Hans-JR/NMEA-Motor-Diagnose/README.md

# NMEA-Motor-Diagnose
Monitors several Boot Engine Parameter and converts them into the NMEA0183 protocoll

The Project is listet under the URL https://open-boat-projects.org/de/diy-motordiagnose/
