Hans-JR/NMEA-Motor-Diagnose/KiCad/BOM.xlsx

Ref. Nr. | Bezeichnung | Artikel Nr. (Reichelt) | Link
J1 | Klemmleiste | WAGO-250-2002 | WAGO 250-202: Klemmleiste mit Betätigungsdrückern, RM 3,5 mm, 8A, 2-pol bei reichelt elektronik (https://www.reichelt.de/klemmleiste-mit-betaetigungsdrueckern-rm-3-5-mm-8a-2-pol-wago-250-202-p100833.html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)
J2 | Klemmleiste | WAGO-250-2003 | WAGO 250-203: Klemmleiste mit Betätigungsdrückern, RM 3,5 mm, 8A, 3-pol bei reichelt elektronik (https://www.reichelt.de/klemmleiste-mit-betaetigungsdrueckern-rm-3-5-mm-8a-3-pol-wago-250-203-p100834.html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)
J3 | Klemmleiste | WAGO-250-2006 | WAGO 250-206: Klemmleiste mit Betätigungsdrückern, RM 3,5 mm, 8A, 6-pol bei reichelt elektronik (https://www.reichelt.de/klemmleiste-mit-betaetigungsdrueckern-rm-3-5-mm-8a-6-pol-wago-250-206-p100836.html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)
J4 | Klemmleiste | WAGO-250-2006 | WAGO 250-206: Klemmleiste mit Betätigungsdrückern, RM 3,5 mm, 8A, 6-pol bei reichelt elektronik (https://www.reichelt.de/klemmleiste-mit-betaetigungsdrueckern-rm-3-5-mm-8a-6-pol-wago-250-206-p100836.html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)
J5 | Klemmleiste | WAGO-250-2008 | WAGO 250-208: Klemmleiste mit Betätigungsdrückern, RM 3,5 mm, 8A, 8-pol bei reichelt elektronik (https://www.reichelt.de/klemmleiste-mit-betaetigungsdrueckern-rm-3-5-mm-8a-8-pol-wago-250-208-p100837.html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)
D1 | 1N4007 | 1N 4007 Gleichrichterdiode, 1000 V, 1 A, DO-41 | 1N 4007: Gleichrichterdiode, 1000 V, 1 A, DO-41 bei reichelt elektronik (https://www.reichelt.de/gleichrichterdiode-1000-v-1-a-do-41-1n-4007-p1729.html?search=1n4007)
D2 | 1N4728 | 1,5KE 27A TVS-Diode, unidirektional, 23,1 V, 1500 W, DO-201 | 1,5KE 27A: TVS-Diode, unidirektional, 23,1 V, 1500 W, DO-201 bei reichelt elektronik (https://www.reichelt.de/tvs-diode-unidirektional-23-1-v-1500-w-do-201-1-5ke-27a-p41862.html?PROVID=2788)
D3 | 1N4007 | 1N 4007 Gleichrichterdiode, 1000 V, 1 A, DO-41 | 1N 4007: Gleichrichterdiode, 1000 V, 1 A, DO-41 bei reichelt elektronik (https://www.reichelt.de/gleichrichterdiode-1000-v-1-a-do-41-1n-4007-p1729.html?search=1n4007)
D4 | LED 5mm grün | LED 5MM R GN | bei reichelt elektronik (https://www.reichelt.de/index.html?ACTION=446&LA=3&nbc=1&q=led%205mm%20r%20gn)
D5 | LED 5mm rot | LED 5MM R RT | bei reichelt elektronik (https://www.reichelt.de/index.html?ACTION=446&LA=446&nbc=1&q=led%205mm%20r%20rt)
C1 | 2200µf, 25V | NHG-A 2,2M 25 Elko, radial, 2.200µF, 25V, RM5,0, | NHG-A 2,2M 25: Elko, radial, 2.200µF, 25V, RM5,0, 1000h, 105°C, 20% bei reichelt elektronik (https://www.reichelt.de/elko-radial-2-200-f-25v-rm5-0-1000h-105-c-20--nhg-a-2-2m-25-p200403.html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)
C2 | 2200µf, 15V | NHG-A 2,2M 25 Elko, radial, 2.200µF, 25V, RM5,0, | NHG-A 2,2M 25: Elko, radial, 2.200µF, 25V, RM5,0, 1000h, 105°C, 20% bei reichelt elektronik (https://www.reichelt.de/elko-radial-2-200-f-25v-rm5-0-1000h-105-c-20--nhg-a-2-2m-25-p200403.html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)
C3 | 220µf, 25V | NHG-A 220U 25 Elko, radial, 220µF, 25V, RM3,5 | NHG-A 220U 25: Elko, radial, 220µF, 25V, RM3,5, 1000h, 105°C, 20% bei reichelt elektronik (https://www.reichelt.de/elko-radial-220-f-25v-rm3-5-1000h-105-c-20--nhg-a-220u-25-p200373.html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)
C4 | 2200µf, 25V | NHG-A 2,2M 25 Elko, radial, 2.200µF, 25V, RM5,0, | NHG-A 2,2M 25: Elko, radial, 2.200µF, 25V, RM5,0, 1000h, 105°C, 20% bei reichelt elektronik (https://www.reichelt.de/elko-radial-2-200-f-25v-rm5-0-1000h-105-c-20--nhg-a-2-2m-25-p200403.html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)
C5 | 100nf | KERKO-500 100P Keramik-Kondensator, 500V, 100P | KERKO-500 100P: Keramik-Kondensator, 500V, 100P bei reichelt elektronik (https://www.reichelt.de/keramik-kondensator-500v-100p-kerko-500-100p-p9316.html?&trstct=pol_1&nbc=1)
C6 | 220µf, 25V | NHG-A 220U 25 Elko, radial, 220µF, 25V, RM3,5 | NHG-A 220U 25: Elko, radial, 220µF, 25V, RM3,5, 1000h, 105°C, 20% bei reichelt elektronik (https://www.reichelt.de/elko-radial-220-f-25v-rm3-5-1000h-105-c-20--nhg-a-220u-25-p200373.html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)
U1 | REF2CP | REF 02 CP | REF 02 CP: Spannungsreferenz, fest, 5 V, DIP-8 bei reichelt elektronik (https://www.reichelt.de/spannungsreferenz-fest-5-v-dip-8-ref-02-cp-p15196.html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)
U2 | DC DC Adapter | LM2596S DC-DC Netzteil Adapter Step down Modul | LM2596S DC-DC Netzteil Adapter Step down Modul für Arduino – AZ-Delivery (az-delivery.de) (https://az-delivery.de/collections/basis-produkte/products/lm2596s-dc-dc-step-down-modul-1)
U3 | WEMOS mini D1 | Ebay | D1 ESP8266 Mini WLAN Board Mikrokontroller Wifi Modul Wemos Nodemcu Arduino | eBay (https://www.ebay.de/itm/254535886946)
Q1 | BC 237, BC547 | BC 547C Bipolartransistor, NPN, 45V, 0,1A, 0,5W, TO-92 | BC 547C: Bipolartransistor, NPN, 45V, 0,1A, 0,5W, TO-92 bei reichelt elektronik (https://www.reichelt.de/bipolartransistor-npn-45v-0-1a-0-5w-to-92-bc-547c-p5007.html?search=bc+547)
Q2 | BC 237, BC547 |  | BC 547C: Bipolartransistor, NPN, 45V, 0,1A, 0,5W, TO-92 bei reichelt elektronik (https://www.reichelt.de/bipolartransistor-npn-45v-0-1a-0-5w-to-92-bc-547c-p5007.html?search=bc+547)
Q3 | BC 237, BC547 |  | BC 547C: Bipolartransistor, NPN, 45V, 0,1A, 0,5W, TO-92 bei reichelt elektronik (https://www.reichelt.de/bipolartransistor-npn-45v-0-1a-0-5w-to-92-bc-547c-p5007.html?search=bc+547)
Q4 | BC 557 | BC 557B Bipolartransistor, PNP, 45V, 0,1A, 0,5W, TO-92 | BC 557B: Bipolartransistor, PNP, 45V, 0,1A, 0,5W, TO-92 bei reichelt elektronik (https://www.reichelt.de/bipolartransistor-pnp-45v-0-1a-0-5w-to-92-bc-557b-p35845.html?trstct=pos_1&nbc=1)
R1 | 10k
R2 | 160
R3 | 10k
R4 | 1k
R5 | 10k
R6 | 80
na | Gehäuse | RND 455-00230 Kunststoffgehäuse, 115 x 90 x 55 mm, IP65 | RND 455-00230: Kunststoffgehäuse, 115 x 90 x 55 mm, IP65 bei reichelt elektronik (https://www.reichelt.de/kunststoffgehaeuse-115-x-90-x-55-mm-ip65-rnd-455-00230-p193444.html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)
na | Reflexsensor
na | Temp Sensor
na | WEMOS SD-Cardreader | Ebay | Micro SD Card Karten Shield Erweiterung für Wemos D1 Mini Speicher Modul | eBay (https://www.ebay.de/itm/254535686828)
