Hans-JR/NMEA-Motor-Diagnose/KiCad/Motordiag_V3.kicad_pcb

## KiCad design KiCad/Motordiag_V3.kicad_pcb (2021-12-27)

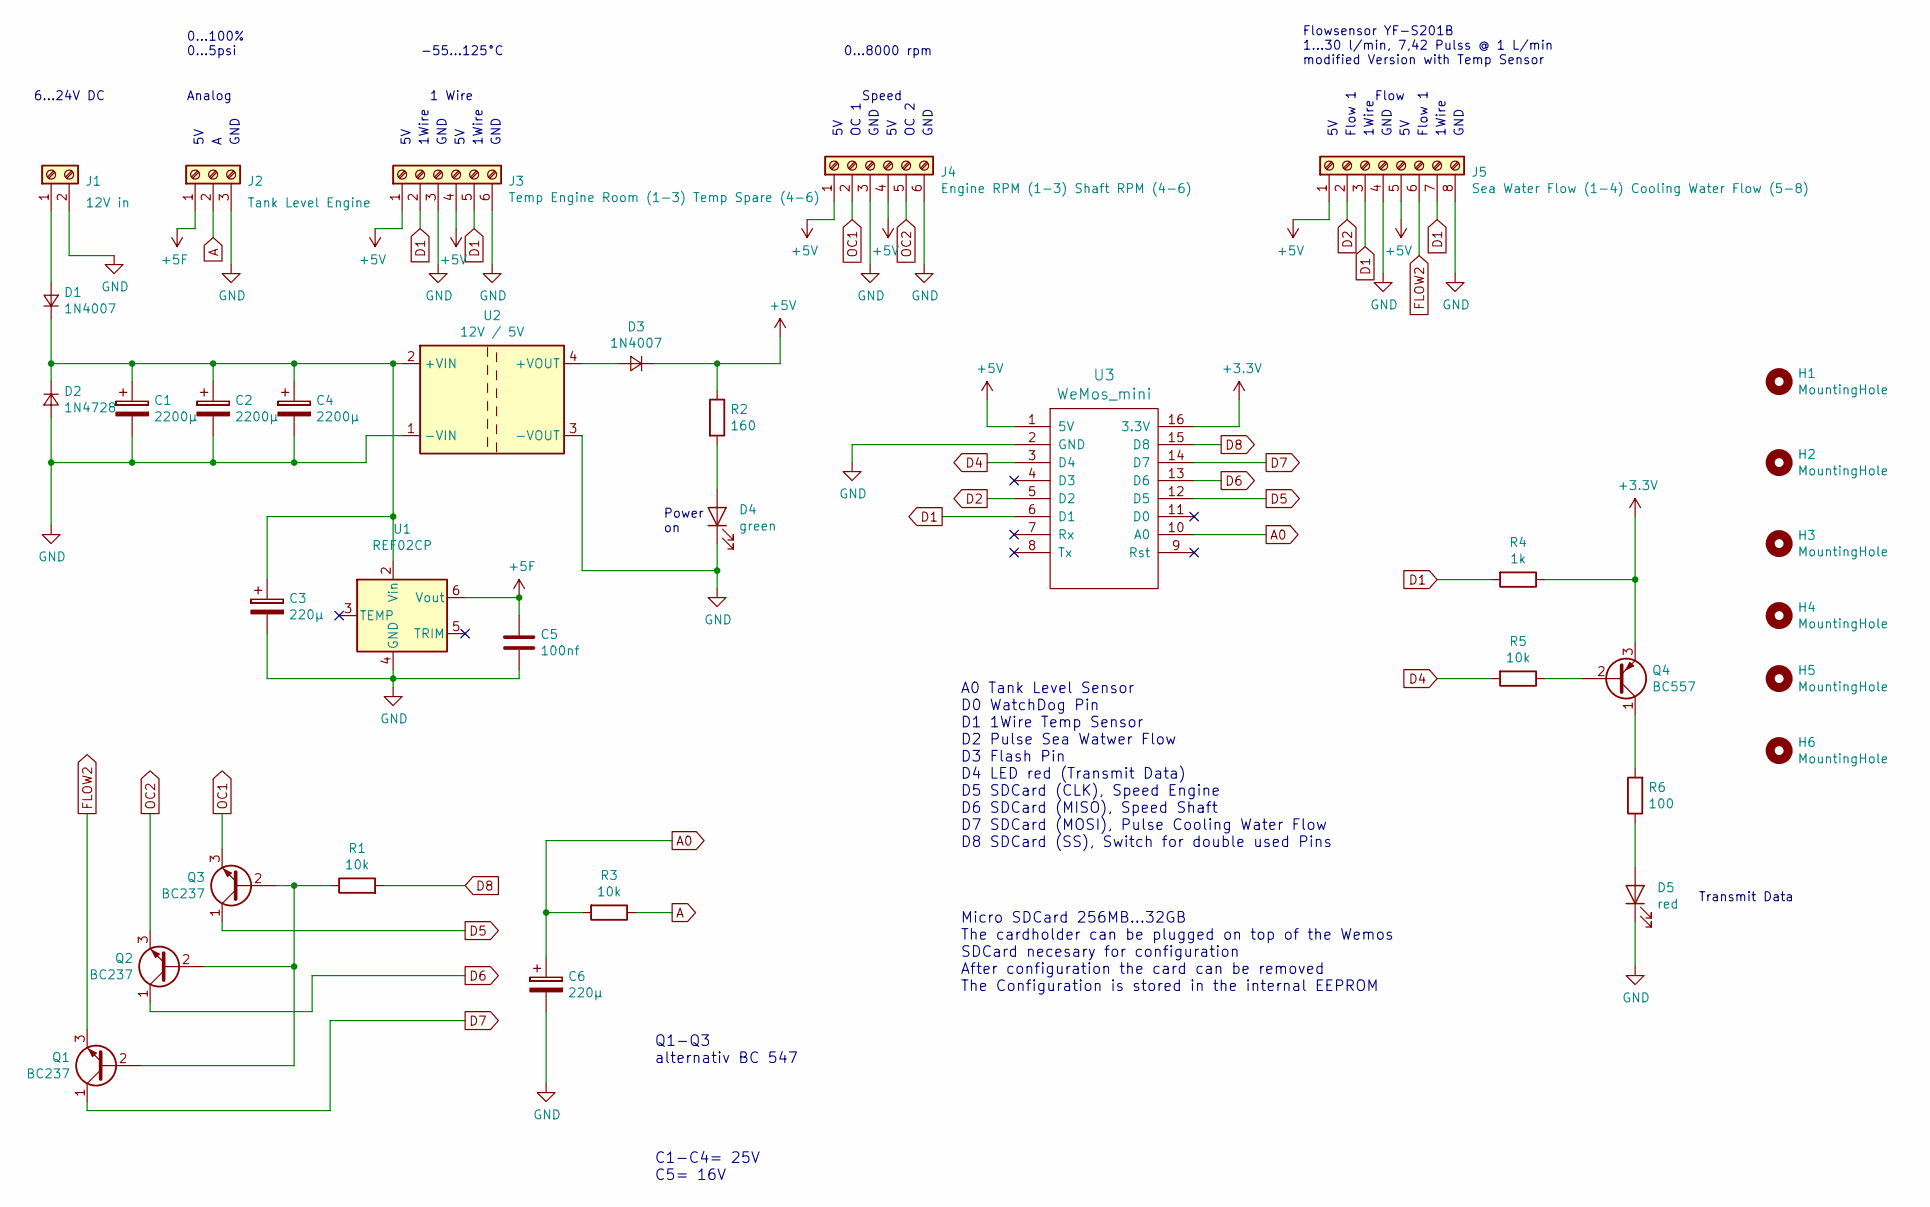
[picture p1: schematic Motordiag_V3.sch, NMEA Motor Diag]

Parts:
C1, C2, C4: 2200µ; CP_Radial_D12.5mm_P5.00mm
C3, C6: 220µ; CP_Radial_D8.0mm_P5.00mm
C5: 100nf; C_Rect_L7.0mm_W2.5mm_P5.00mm
D1, D3: 1N4007; D_DO-41_SOD81_P10.16mm_Horizontal
D2: 1N4728; D_DO-201_P12.70mm_Horizontal
D4: green; LED_D5.0mm
D5: red; LED_D5.0mm
H1, H2: MountingHole; MountingHole_3.2mm_M3
H3, H4, H5, H6: MountingHole; MountingHole_3.5mm_Pad
J1: 12V in; 250-202
J2: Tank Level Engine; 250-203
J3: Temp Engine Room (1-3) Temp Spare (4-6); 250-206
J4: Engine RPM (1-3) Shaft RPM (4-6); 250-206
J5: Sea Water Flow (1-4) Cooling Water Flow (5-8); 250-208
Q1, Q2, Q3: BC237; TO-92_Inline
Q4: BC557; TO-92_Inline
R1, R3, R5: 10k; R_Axial_DIN0309_L9.0mm_D3.2mm_P12.70mm_Horizontal
R2: 160; R_Axial_DIN0309_L9.0mm_D3.2mm_P12.70mm_Horizontal
R4: 1k; R_Axial_DIN0309_L9.0mm_D3.2mm_P12.70mm_Horizontal
R6: 100; R_Axial_DIN0309_L9.0mm_D3.2mm_P12.70mm_Horizontal
U1: REF02CP; DIP-8_W7.62mm
U2: 12V / 5V; Converter_DCDC_LM2596S_Modul
U3: WeMos_mini; D1_mini_board

Connections:
+3V3: Q4.3 (E), R4.1, U3.16 (3.3V)
+5F: C5.1, J2.1, U1.6 (Vout)
+5V: D3.1 (K), J3.1, J3.4, J4.1, J4.4, J5.1, J5.5, R2.1, U3.1 (5V)
A: J2.2, R3.1
A0: C6.1, R3.2, U3.10 (A0)
D1: J3.2, J3.5, J5.3, J5.7, R4.2, U3.6 (D1)
D2: J5.2, U3.5 (D2)
D4: R5.2, U3.3 (D4)
D5: Q3.1 (C), U3.12 (D5)
D6: Q2.1 (C), U3.13 (D6)
D7: Q1.1 (C), U3.14 (D7)
D8: R1.2, U3.15 (D8)
FLOW2: J5.6, Q1.3 (E)
GND: C1.2, C2.2, C3.2, C4.2, C5.2, C6.2, D2.2 (A), D4.1 (K), D5.1 (K), J1.2, J2.3, J3.3, J3.6, J4.3, J4.6, J5.4, J5.8, U1.4 (GND), U2.1 (-VIN), U2.3 (-VOUT), U3.2 (GND)
unnamed: C1.1, C2.1, C3.1, C4.1, D1.1 (K), D2.1 (K), U1.2 (Vin), U2.2 (+VIN)
unnamed: D1.2 (A), J1.1
unnamed: D3.2 (A), U2.4 (+VOUT)
unnamed: D4.2 (A), R2.2
unnamed: D5.2 (A), R6.1
unnamed: Q1.2 (B), Q2.2 (B), Q3.2 (B), R1.1
unnamed: Q4.1 (C), R6.2
unnamed: Q4.2 (B), R5.1
OC1: J4.2, Q3.3 (E)
OC2: J4.5, Q2.3 (E)

Notes on the sheet:
GND
1Wire
Analog
1 Wire
Speed
OC 1
OC 2
Flow
Flow 1
C1-C4= 25V C5= 16V
6...24V DC
0...100% 0...5psi
-55...125°C
0...8000 rpm
Flowsensor YF-S201B 1...30 l/min, 7,42 Pulss @ 1 L/min modified Version with Temp Sensor
Transmit Data
Power on
Micro SDCard 256MB...32GB The cardholder can be plugged on top of the Wemos SDCard necesary for configuration After configuration the card can be removed The Configuration is stored in the internal EEPROM
A0 Tank Level Sensor D0 WatchDog Pin D1 1Wire Temp Sensor D2 Pulse Sea Watwer Flow D3 Flash Pin D4 LED red (Transmit Data) D5 SDCard (CLK), Speed Engine D6 SDCard (MISO), Speed Shaft D7 SDCard (MOSI), Pulse Cooling Water Flow D8 SDCard (SS), Switch for double used Pins
Q1-Q3 alternativ BC 547

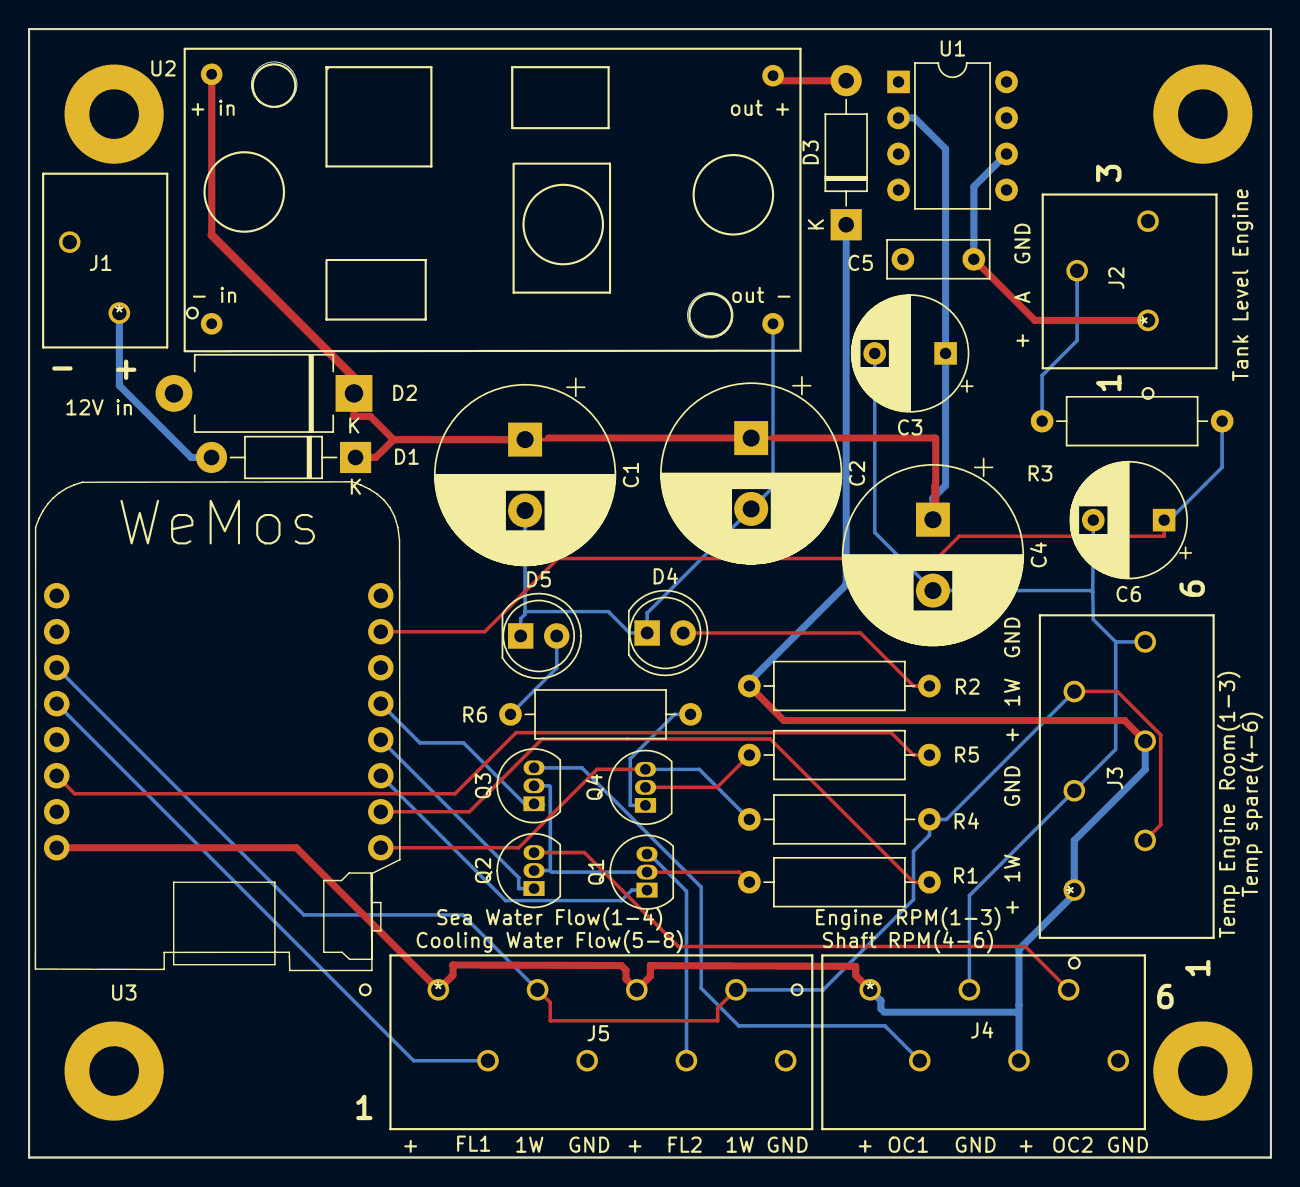
[picture p2: board Motordiag_V3.kicad_pcb from above]

Board: 2 copper layers, 87.6 x 79.6 mm, 35 parts (0 on the bottom side), 24 nets.
