Hans-JR/NMEA-Motor-Diagnose/(notices)

Notices in the files:
KiCad/Motordiag_V3.kicad_pcb:
CC BY-NC-SA
parts and their libraries:
Copyright 2016 Accelerated Designs. All rights reserved.
